goncalor/SCDTR/report/final/report.tex

\documentclass[a4paper,11pt]{article}

\usepackage{tecnico_relatorio}

\usepackage{textcomp}
\usepackage[justification=centering,hypcap]{caption} % makes \ref point to top of figures and tables
\usepackage{subcaption}
%\usepackage{rotating}
\usepackage{float}
\usepackage[nottoc]{tocbibind}
\usepackage[utf8]{inputenc}
\usepackage{graphicx}
\usepackage{listings}
\usepackage{indentfirst} % indent first paragraph in section
\usepackage{geometry}	% margins
\usepackage[siunitx]{circuitikz}	 % draw circuits
\usepackage{setspace}
\usepackage{amsmath}

% magic for listings (make them beautiful)
\usepackage{color}
\usepackage{xcolor}

%\definecolor{very-light-gray}{rgb}{0.95, 0.95, 0.95}
%\DeclareCaptionFont{white}{\color{white}}
%\DeclareCaptionFormat{listing}{\colorbox{gray}{\parbox{\textwidth}{#1#2#3}}}
%\captionsetup[lstlisting]{format=listing, labelfont=white, textfont=white}
%\lstset{backgroundcolor = \color{very-light-gray}, xleftmargin=7pt, frame=lr, framesep=7pt, framerule=0pt, breaklines=true, tabsize=4, showstringspaces=false}

% a tab is 4 spaces
%\usepackage{fancyvrb}
%\fvset{tabsize=2}

\begin{document}
\newgeometry{left=4.0cm,right=4.0cm}

\trSetImage{img/tecnico_logo}{6cm} % Logotipo do Técnico

\trSetCourse{Mestrado em Engenharia Electrotécnica \\e de Computadores}

\trSetSubject{Sistemas de Controlo Distribuído \\[3mm] em Tempo Real}

\trSetType{Project Report}

\trSetTitle{Distributed	Lighting Control}

\trSetBoxStyle{0.3}

\trSetGroupNo{Group 1}

\trSetAuthorNr{2}

\trSetAuthors
{
    \begin{center}
	Gonçalo Ribeiro

	73294
    \end{center}
}{
    \begin{center}
	João Almeida

	73198
    \end{center}
}

\trSetProfessor{Prof. José Gaspar \\ Prof. Alexandre Bernardino}

\trMakeCover

\restoregeometry
\newgeometry{left=2.5cm,right=2.5cm}

\onehalfspacing

\tableofcontents
\pagenumbering{gobble}

\pagebreak

\pagenumbering{arabic}
\setcounter{page}{1}

\input{Abstract}
\input{Introduction}
%\section{Background}
\input{Approach}
\input{Experiments}
\input{ResultsDiscussion}
\input{Conclusion}

\pagebreak
% references
\nocite{*}
\bibliography{references}
\bibliographystyle{abbrv}

\end{document}
