goncalor/SCDTR/datasheets/links.md

https://learn.adafruit.com/photocells/overview
http://www.adafruit.com/products/754		(Super Bright White LED)
