goncalor/SCDTR/report/final/img/steady_state.tex

% Title: glps_renderer figure
% Creator: GL2PS 1.3.8, (C) 1999-2012 C. Geuzaine
% For: Octave
% CreationDate: Tue Dec 29 23:09:54 2015
\setlength{\unitlength}{1pt}
\begin{picture}(0,0)

\end{picture}%
\begin{picture}(576,432)(0,0)
\fontsize{10}{0}
\selectfont\put(74.88,42.5189){\makebox(0,0)[t]{\textcolor[rgb]{0,0,0}{{0}}}}
\fontsize{10}{0}
\selectfont\put(162.409,42.5189){\makebox(0,0)[t]{\textcolor[rgb]{0,0,0}{{50}}}}
\fontsize{10}{0}
\selectfont\put(249.939,42.5189){\makebox(0,0)[t]{\textcolor[rgb]{0,0,0}{{100}}}}
\fontsize{10}{0}
\selectfont\put(337.468,42.5189){\makebox(0,0)[t]{\textcolor[rgb]{0,0,0}{{150}}}}
\fontsize{10}{0}
\selectfont\put(424.998,42.5189){\makebox(0,0)[t]{\textcolor[rgb]{0,0,0}{{200}}}}
\fontsize{10}{0}
\selectfont\put(512.527,42.5189){\makebox(0,0)[t]{\textcolor[rgb]{0,0,0}{{250}}}}
\fontsize{10}{0}
\selectfont\put(69.8755,47.52){\makebox(0,0)[r]{\textcolor[rgb]{0,0,0}{{0}}}}
\fontsize{10}{0}
\selectfont\put(69.8755,135.54){\makebox(0,0)[r]{\textcolor[rgb]{0,0,0}{{1}}}}
\fontsize{10}{0}
\selectfont\put(69.8755,223.56){\makebox(0,0)[r]{\textcolor[rgb]{0,0,0}{{2}}}}
\fontsize{10}{0}
\selectfont\put(69.8755,311.58){\makebox(0,0)[r]{\textcolor[rgb]{0,0,0}{{3}}}}
\fontsize{10}{0}
\selectfont\put(69.8755,399.6){\makebox(0,0)[r]{\textcolor[rgb]{0,0,0}{{4}}}}
\fontsize{10}{0}
\selectfont\put(298.08,31.5188){\makebox(0,0)[t]{\textcolor[rgb]{0,0,0}{{PWM value (0--255)}}}}
\fontsize{10}{0}
\selectfont\put(59.8755,223.56){\rotatebox{90}{\makebox(0,0)[b]{\textcolor[rgb]{0,0,0}{{Voltage at \texttt{A0} (\si{\volt})}}}}}
\end{picture}
