goncalor/SCDTR/report/final/img/pwm_to_lux.tex

% Title: glps_renderer figure
% Creator: GL2PS 1.3.8, (C) 1999-2012 C. Geuzaine
% For: Octave
% CreationDate: Tue Dec 29 00:58:25 2015
\setlength{\unitlength}{1pt}
\begin{picture}(0,0)

\end{picture}%
\begin{picture}(576,432)(0,0)
\fontsize{10}{0}
\selectfont\put(74.88,42.5189){\makebox(0,0)[t]{\textcolor[rgb]{0,0,0}{{0}}}}
\fontsize{10}{0}
\selectfont\put(162.409,42.5189){\makebox(0,0)[t]{\textcolor[rgb]{0,0,0}{{50}}}}
\fontsize{10}{0}
\selectfont\put(249.939,42.5189){\makebox(0,0)[t]{\textcolor[rgb]{0,0,0}{{100}}}}
\fontsize{10}{0}
\selectfont\put(337.468,42.5189){\makebox(0,0)[t]{\textcolor[rgb]{0,0,0}{{150}}}}
\fontsize{10}{0}
\selectfont\put(424.998,42.5189){\makebox(0,0)[t]{\textcolor[rgb]{0,0,0}{{200}}}}
\fontsize{10}{0}
\selectfont\put(512.527,42.5189){\makebox(0,0)[t]{\textcolor[rgb]{0,0,0}{{250}}}}
\fontsize{10}{0}
\selectfont\put(69.8755,47.52){\makebox(0,0)[r]{\textcolor[rgb]{0,0,0}{{0}}}}
\fontsize{10}{0}
\selectfont\put(69.8755,106.2){\makebox(0,0)[r]{\textcolor[rgb]{0,0,0}{{10}}}}
\fontsize{10}{0}
\selectfont\put(69.8755,164.88){\makebox(0,0)[r]{\textcolor[rgb]{0,0,0}{{20}}}}
\fontsize{10}{0}
\selectfont\put(69.8755,223.56){\makebox(0,0)[r]{\textcolor[rgb]{0,0,0}{{30}}}}
\fontsize{10}{0}
\selectfont\put(69.8755,282.24){\makebox(0,0)[r]{\textcolor[rgb]{0,0,0}{{40}}}}
\fontsize{10}{0}
\selectfont\put(69.8755,340.92){\makebox(0,0)[r]{\textcolor[rgb]{0,0,0}{{50}}}}
\fontsize{10}{0}
\selectfont\put(69.8755,399.6){\makebox(0,0)[r]{\textcolor[rgb]{0,0,0}{{60}}}}
\fontsize{10}{0}
\selectfont\put(298.08,31.5188){\makebox(0,0)[t]{\textcolor[rgb]{0,0,0}{{PWM value (0--255)}}}}
\fontsize{10}{0}
\selectfont\put(53.8755,223.56){\rotatebox{90}{\makebox(0,0)[b]{\textcolor[rgb]{0,0,0}{{Measured illuminance (\si{\lux})}}}}}
\end{picture}
