goncalor/SCDTR/report/part1/Deliverables/D2/steadystate.csv

LED, | LDR, | Volts
0, | 3, | 0.0146484375
1, | 3, | 0.0146484375
2, | 50, | 0.244140625
3, | 80, | 0.390625
4, | 104, | 0.5078125
5, | 126, | 0.615234375
6, | 145, | 0.7080078125
7, | 162, | 0.791015625
8, | 178, | 0.869140625
9, | 192, | 0.9375
10, | 207, | 1.0107421875
11, | 219, | 1.0693359375
12, | 232, | 1.1328125
13, | 243, | 1.1865234375
14, | 257, | 1.2548828125
15, | 266, | 1.298828125
16, | 275, | 1.3427734375
17, | 285, | 1.3916015625
18, | 295, | 1.4404296875
19, | 303, | 1.4794921875
20, | 312, | 1.5234375
21, | 319, | 1.5576171875
22, | 328, | 1.6015625
23, | 335, | 1.6357421875
24, | 343, | 1.6748046875
25, | 350, | 1.708984375
26, | 356, | 1.73828125
27, | 363, | 1.7724609375
28, | 369, | 1.8017578125
29, | 375, | 1.8310546875
30, | 384, | 1.875
31, | 390, | 1.904296875
32, | 393, | 1.9189453125
33, | 399, | 1.9482421875
34, | 404, | 1.97265625
35, | 409, | 1.9970703125
36, | 414, | 2.021484375
37, | 419, | 2.0458984375
38, | 424, | 2.0703125
39, | 429, | 2.0947265625
40, | 434, | 2.119140625
41, | 438, | 2.138671875
42, | 442, | 2.158203125
43, | 446, | 2.177734375
44, | 451, | 2.2021484375
45, | 454, | 2.216796875
46, | 461, | 2.2509765625
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
