goncalor/SCDTR/report/part1/Deliverables/D2/steadystate.xlsx

LED | LDR | Volts
0 | 3 | 0.0146484375
1 | 3 | 0.0146484375
2 | 50 | 0.244140625
3 | 80 | 0.390625
4 | 104 | 0.5078125
5 | 126 | 0.615234375
6 | 145 | 0.7080078125
7 | 162 | 0.791015625
8 | 178 | 0.869140625
9 | 192 | 0.9375
10 | 207 | 1.010742188
11 | 219 | 1.069335938
12 | 232 | 1.1328125
13 | 243 | 1.186523438
14 | 257 | 1.254882812
15 | 266 | 1.298828125
16 | 275 | 1.342773438
17 | 285 | 1.391601562
18 | 295 | 1.440429688
19 | 303 | 1.479492188
20 | 312 | 1.5234375
21 | 319 | 1.557617188
22 | 328 | 1.6015625
23 | 335 | 1.635742188
24 | 343 | 1.674804688
25 | 350 | 1.708984375
26 | 356 | 1.73828125
27 | 363 | 1.772460938
28 | 369 | 1.801757812
29 | 375 | 1.831054688
30 | 384 | 1.875
31 | 390 | 1.904296875
32 | 393 | 1.918945312
33 | 399 | 1.948242188
34 | 404 | 1.97265625
35 | 409 | 1.997070312
36 | 414 | 2.021484375
37 | 419 | 2.045898438
38 | 424 | 2.0703125
39 | 429 | 2.094726562
40 | 434 | 2.119140625
41 | 438 | 2.138671875
42 | 442 | 2.158203125
43 | 446 | 2.177734375
44 | 451 | 2.202148438
45 | 454 | 2.216796875
46 | 461 | 2.250976562
47 | 465 | 2.270507812
48 | 469 | 2.290039062
49 | 471 | 2.299804688
50 | 474 | 2.314453125
51 | 478 | 2.333984375
52 | 481 | 2.348632812
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
