goncalor/SCDTR/report/part1/Deliverables/D4/pwm_to_lux.csv

PWM, | ADC 0 to 1024, | Volts, | lux
0, | 2, | 0.009765625, | 0.0015958195
1, | 14, | 0.068359375, | 0.0272282088
2, | 33, | 0.1611328125, | 0.0969576472
3, | 56, | 0.2734375, | 0.2158603265
4, | 77, | 0.3759765625, | 0.3534967077
5, | 97, | 0.4736328125, | 0.509486053
6, | 116, | 0.56640625, | 0.6803579883
7, | 135, | 0.6591796875, | 0.8739853255
8, | 152, | 0.7421875, | 1.0673234428
9, | 168, | 0.8203125, | 1.2674624641
10, | 183, | 0.8935546875, | 1.4719111751
11, | 197, | 0.9619140625, | 1.6781779812
12, | 211, | 1.0302734375, | 1.9001524699
13, | 224, | 1.09375, | 2.1210871611
14, | 236, | 1.15234375, | 2.3383603645
15, | 248, | 1.2109375, | 2.56910073
16, | 259, | 1.2646484375, | 2.7930445103
17, | 269, | 1.3134765625, | 3.0074560374
18, | 280, | 1.3671875, | 3.2558000438
19, | 290, | 1.416015625, | 3.4934731446
20, | 299, | 1.4599609375, | 3.7175369932
21, | 307, | 1.4990234375, | 3.925137115
22, | 316, | 1.54296875, | 4.1685801272
23, | 324, | 1.58203125, | 4.3941355856
24, | 332, | 1.62109375, | 4.6286800779
25, | 340, | 1.66015625, | 4.8725855995
26, | 347, | 1.6943359375, | 5.093990332
27, | 355, | 1.7333984375, | 5.3565246962
28, | 361, | 1.7626953125, | 5.5603257703
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
