goncalor/SCDTR/report/part1/Deliverables/D4/pwm_to_lux.xlsx

PWM | ADC 0 to 1024 | Volts | lux | a | -0.6901
0 | 2 | 0.009765625 | 0.00159581951 | b | 4.7782
1 | 14 | 0.068359375 | 0.02722820881 | R | 10000
2 | 33 | 0.1611328125 | 0.09695764723
3 | 56 | 0.2734375 | 0.2158603265
4 | 77 | 0.3759765625 | 0.3534967077
5 | 97 | 0.4736328125 | 0.509486053
6 | 116 | 0.56640625 | 0.6803579883
7 | 135 | 0.6591796875 | 0.8739853255
8 | 152 | 0.7421875 | 1.067323443
9 | 168 | 0.8203125 | 1.267462464
10 | 183 | 0.8935546875 | 1.471911175
11 | 197 | 0.9619140625 | 1.678177981
12 | 211 | 1.030273438 | 1.90015247
13 | 224 | 1.09375 | 2.121087161
14 | 236 | 1.15234375 | 2.338360365
15 | 248 | 1.2109375 | 2.56910073
16 | 259 | 1.264648438 | 2.79304451
17 | 269 | 1.313476562 | 3.007456037
18 | 280 | 1.3671875 | 3.255800044
19 | 290 | 1.416015625 | 3.493473145
20 | 299 | 1.459960938 | 3.717536993
21 | 307 | 1.499023438 | 3.925137115
22 | 316 | 1.54296875 | 4.168580127
23 | 324 | 1.58203125 | 4.394135586
24 | 332 | 1.62109375 | 4.628680078
25 | 340 | 1.66015625 | 4.872585599
26 | 347 | 1.694335938 | 5.093990332
27 | 355 | 1.733398438 | 5.356524696
28 | 361 | 1.762695312 | 5.56032577
29 | 368 | 1.796875 | 5.805853545
30 | 374 | 1.826171875 | 6.023188681
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
