goncalor/SCDTR/report/part1/Deliverables/D1/12188851_10206899565321801_85842977_n.jpg

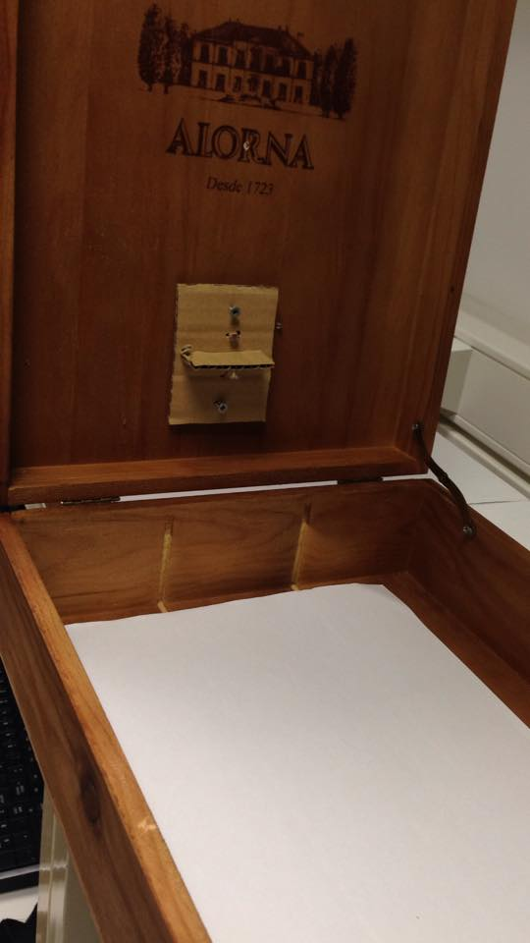
report/part1/Deliverables/D1/12188851_10206899565321801_85842977_n.jpg
