goncalor/SCDTR/Arduino/step_response/step_response_no_capacitor.csv

time, | LDR, | LED
1000456, | 6, | 0
1001072, | 5, | 0
1001728, | 6, | 0
1002376, | 5, | 0
1003024, | 6, | 0
1003680, | 5, | 0
1004328, | 5, | 0
1004976, | 4, | 0
1005632, | 5, | 0
1006824, | 6, | 0
1008096, | 6, | 0
1009368, | 6, | 0
1010648, | 5, | 0
1011920, | 5, | 0
1013192, | 5, | 0
1014472, | 5, | 0
1015744, | 5, | 0
1017016, | 6, | 0
1018296, | 5, | 0
1019568, | 6, | 0
1020856, | 5, | 128
1022288, | 88, | 128
1023816, | 140, | 128
1025432, | 214, | 128
1027048, | 236, | 128
1028664, | 316, | 128
1030280, | 315, | 128
1031896, | 369, | 128
1033512, | 391, | 128
1035128, | 405, | 128
1036736, | 445, | 128
1038352, | 432, | 128
1039968, | 461, | 128
1041584, | 468, | 128
1043200, | 491, | 128
1044816, | 504, | 128
1046432, | 500, | 128
1048048, | 530, | 128
1049664, | 506, | 128
1051272, | 543, | 128
1052888, | 533, | 128
1054504, | 542, | 128
1056120, | 554, | 128
1057736, | 542, | 128
1059352, | 570, | 128
1060968, | 545, | 128
1062576, | 572, | 128
1064192, | 566, | 128
1065808, | 567, | 128
1067424, | 581, | 128
1069040, | 564, | 128
1070656, | 593, | 128
1072272, | 570, | 128
1073888, | 587, | 128
1075504, | 587, | 128
1077112, | 581, | 128
1078728, | 598, | 128
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
