goncalor/SCDTR/Arduino/step_response/step_response.csv

time, | LDR, | LED
1000472, | 4, | 0
1001088, | 4, | 0
1001744, | 4, | 0
1002392, | 4, | 0
1003040, | 4, | 0
1003696, | 4, | 0
1004344, | 4, | 0
1004992, | 3, | 0
1005648, | 4, | 0
1006832, | 4, | 0
1008112, | 4, | 0
1009384, | 4, | 0
1010664, | 4, | 0
1011936, | 3, | 0
1013208, | 4, | 0
1014488, | 3, | 0
1015760, | 3, | 0
1017040, | 4, | 0
1018312, | 3, | 0
1019584, | 4, | 0
1020872, | 4, | 128
1022304, | 11, | 128
1023832, | 24, | 128
1025368, | 47, | 128
1026896, | 73, | 128
1028424, | 105, | 128
1030040, | 140, | 128
1031656, | 179, | 128
1033272, | 213, | 128
1034888, | 250, | 128
1036504, | 285, | 128
1038120, | 316, | 128
1039728, | 345, | 128
1041344, | 369, | 128
1042960, | 395, | 128
1044576, | 416, | 128
1046192, | 432, | 128
1047808, | 452, | 128
1049424, | 464, | 128
1051032, | 480, | 128
1052648, | 489, | 128
1054264, | 502, | 128
1055880, | 509, | 128
1057496, | 516, | 128
1059112, | 525, | 128
1060728, | 529, | 128
1062344, | 538, | 128
1063952, | 541, | 128
1065568, | 547, | 128
1067184, | 552, | 128
1068800, | 554, | 128
1070416, | 560, | 128
1072032, | 561, | 128
1073648, | 566, | 128
1075264, | 568, | 128
1076872, | 571, | 128
1078488, | 576, | 128
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
