goncalor/SCDTR/graphs/AvgStepRespTau.png

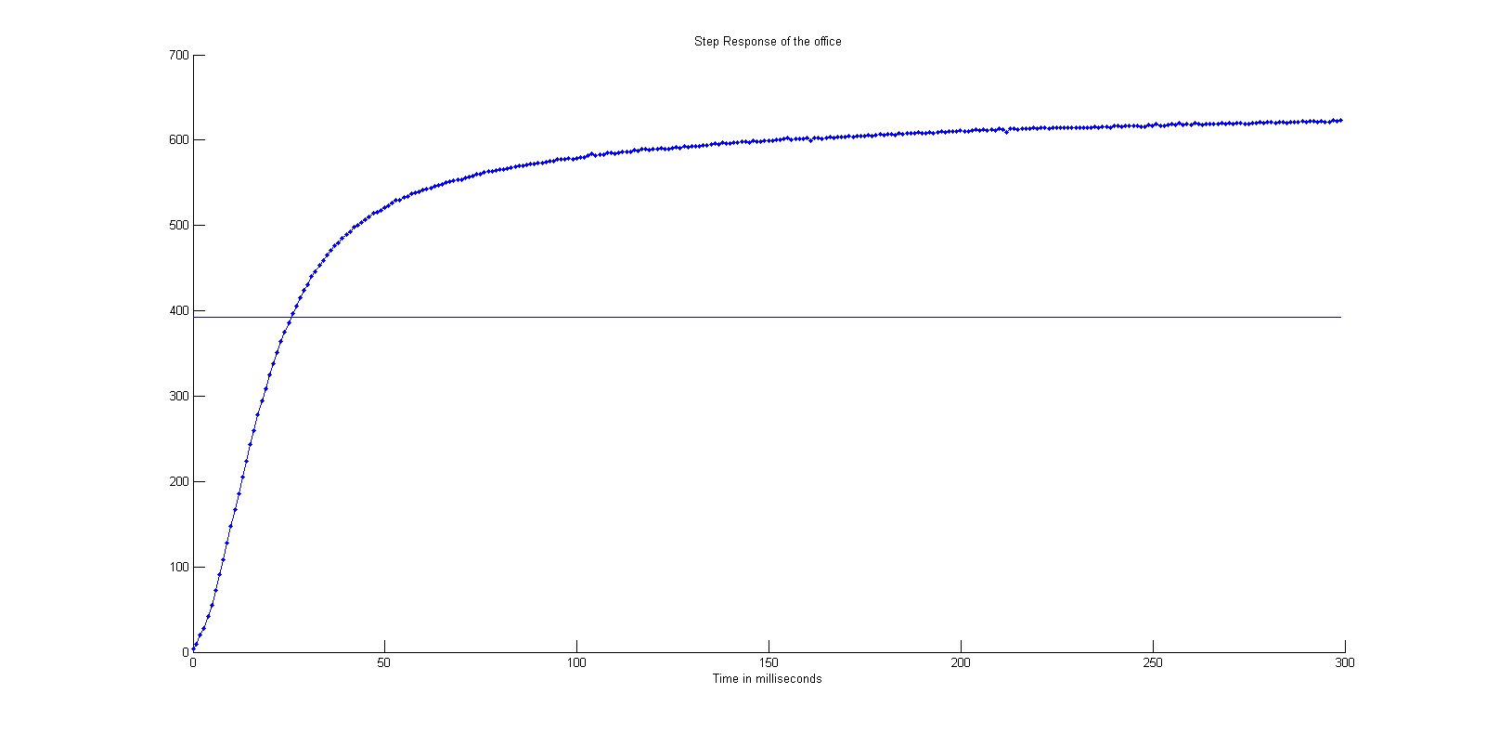
graphs/AvgStepRespTau.png
