goncalor/SCDTR/report/final/SystemCharacteristics.tex

\subsection{System Characteristics}
\label{sec:SystemCharacteristics}

\subsubsection{Steady State}
\label{sub:SteadyState}

The steady state response of the system was determined by setting the duty cycle of the LED to all values in the PWM range 0--255. Each sample was acquired \SI{200}{\milli\second} after the previous one so that the system had time to reach a steady state. This is an adequate time between samples because $RC$ constant of the detector circuit in \autoref{fig:setup_LDR_circuit} is $\tau = R_2C_1 = \SI{60}{\milli\second}$ and \SI{400}{\milli\second} amounts to more than $3\tau$. The reason why $R_2$ is in the time constant and not $R_3$ is because the PWM value was incremented and hence $C_1$ charges via $R_2$. If the data was acquired while decrementing the PWM value $R_3$ would be used instead.

% explain R_2's value above?

A graph of the acquired data can be seen in \autoref{fig:steady_state}. We conclude that the resistance of the LDR does not vary linearly with the duty cycle on the LED. Nonetheless it is possible to obtain a linear function relating the input an output of the system, as described in \ref{subsubsec:LDR_model}.

\begin{figure}[h]
    \centering
    \resizebox{\textwidth}{!}{\input{img/steady_state}}
    \caption{Steady state voltage at pin \texttt{A0} as a function of the duty cycle of the LED.}
    \label{fig:steady_state}
\end{figure}

\subsubsection{Modeling the LDR}
\label{subsubsec:LDR_model}

Since the steady state plot in \autoref{fig:steady_state} reveals that the system is nonlinear it is useful to understand why. The main sources from nonlinearity should result from the LED, the LDR or a combination of both.

% TODO put full datasheet in an annex?

With that in mind the LDR datasheet was analysed. On it the graph in \autoref{fig:LDR_datasheet} can be found. This graph gives a range of values for the resistance of the LDR for each value of incident illuminance. To produce an equation that models the LDR resistance as a function of illuminance the resistance value used for the model is the mean of the maximum and minimum values given for each illuminance. The final result should be a function which produces a line that crosses the middle of the dark region in \autoref{fig:LDR_datasheet}. Note the axis of the figure are both in logarithmic scale. The considered points to obtain this linear function (in a log-log reference) were $(L_1, R_1) = (\SI{100}{\lux}; \SI{2.5}{\kilo\ohm})$ and $(L_2, R_2) = (\SI{1}{\lux}; \SI{60}{\kilo\ohm})$. The model will be an equation in the form
\begin{equation} \label{eq:log-log_line}
    \log_{10} R_{LDR} = a \log_{10} L + b.
\end{equation}

\begin{figure}[h]
    \centering
    \begin{subfigure}[t]{0.39\textwidth}
	\centering
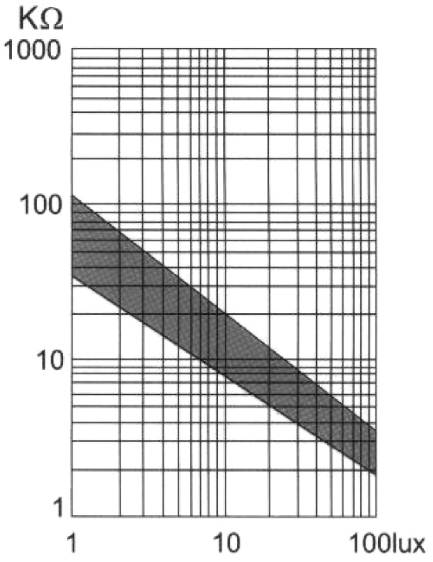
[picture p15: report/final/img/LDR_datasheet.png]
	
	\caption{LDR resistance as a function of illuminance according to the GL5528's datasheet.}
	\label{fig:LDR_datasheet}
    \end{subfigure}
    \begin{subfigure}[t]{0.59\textwidth}
	\centering
	
	\caption{Model for the resistance of the LDR as function of the incident illuminance.}
	\label{fig:LDR_model}
    \end{subfigure}
    \caption{LDR characteristic.}
    %\label{fig:LDR_characteristic}
\end{figure}

We can substitute $(L_1, R_1)$ and $(L_2, R_2)$ in \eqref{eq:log-log_line} to obtain the system of equations
\begin{equation} \label{eq:log-log_line_system}
    \begin{bmatrix}
	\log_{10}R_1 \\ \log_{10}R_2
    \end{bmatrix}
    =
    \begin{bmatrix}
	\log_{10}L_1  &  1 \\
	\log_{10}L_2  &  1
    \end{bmatrix}
    \begin{bmatrix}
	a \\ b
    \end{bmatrix}.
\end{equation}
By solving the system the values $a \approx -0.6901$ and $b \approx 4.7782$ are obtained for this case.

With the values for $a$ and $b$ and \eqref{eq:log-log_line} it is possible to plot the graph in \autoref{fig:LDR_model} which models the LDR characteristic, as desired. Using \eqref{eq:log-log_line} it is possible to obtain the incident illuminance ($L$) from the resistance of the LDR $R_{LDR}$
\begin{equation} \label{eq:Rldr_to_lux}
    L = 10^{-\frac{b}{a}} R_{LDR}^{\frac{1}{a}} .
\end{equation}
And since in a steady state
\begin{equation} \label{eq:VA0_to_Rldr}
    R_{LDR} = \frac{V_S R_3}{V_{\texttt{A0}}} - R_3 ,
\end{equation}
we can substitute \eqref{eq:VA0_to_Rldr} in \eqref{eq:Rldr_to_lux} and apply the new equation to the plot in \autoref{fig:steady_state} to produce the plot in \autoref{fig:pwm_to_lux} which relates the duty cycle of the LED to the illuminance measured by the LDR. We can conclude that the illuminance varies linearly with the duty cycle applied to the LED.

\begin{figure}[h]
    \centering
    \resizebox{0.75\textwidth}{!}{\input{img/pwm_to_lux}}
    \caption{Illuminance detected by the LDR in function of the duty cycle of the LED.}
    \label{fig:pwm_to_lux}
\end{figure}

\subsubsection{Step Response}
\label{sub:StepResponse}

To plot the step response of the system an Arduino program was written that to produce a step and acquire data to be plotted. In this script the LED is first turned off for \SI{1}{\second} so that the capacitor ``fully'' discharges. Then a step is applied to the system by setting the LED duty cycle to 0.5. A sample is acquired and sent to the computer approximately every \SI{1.35}{\milli\second}. The readings are converted to Volt and the result is \autoref{fig:step_response}.

An inflection point can be perceived early in the step response. From this follows that the system's order must be at least second degree. The detector in \autoref{fig:setup_LDR_circuit} includes a capacitor, which must introduce a pole. Therefore an experiment was made which consisted simply in removing the capacitor and acquiring the step response again. The result is shown in \autoref{fig:step_response_no_capacitor} where it can be seen that the aforementioned inflection does not exist. It is also noticeable that introducing the capacitor does filter high frequency noise, as expected. Therefore introducing the capacitor improves the readings but makes the system order increase. Nonetheless the capacitor value can be changed allowing to control the pole position and cutoff frequency.

Assuming that the system can be approximated to a first order system of the form $G(s) = K_0/(1+s\tau)$ the system can be modelled by finding the static gain $K_0$ and the time constant $\tau$. $K_0$ is calculated as the ratio of the output and the input under steady state; the time constant is the time the system takes to reach $1-e^{-1} \approx 63 \%$ of its final value. Therefore for \autoref{fig:step_response} the static gain is $3.08/2.5 = 1.232$ and the time constant is approximately $\SI{23}{\milli\second}$.

If the system is linearised by using the transformation presented in \ref{subsubsec:LDR_model} \autoref{fig:step_response_linearised} is obtained. In this case the static gain is $26.4/2.5 = 10.6$ and the time constant is approximately $\SI{47}{\milli\second}$.

\begin{figure}[h]
    \centering
    \begin{subfigure}[t]{0.49\textwidth}
	\centering
	
	\caption{With capacitor, not linearised.}
	\label{fig:step_response}
    \end{subfigure}
    \begin{subfigure}[t]{0.49\textwidth}
	\centering
	
	\caption{With capacitor, linearised.}
	\label{fig:step_response_linearised}
    \end{subfigure}

    \begin{subfigure}[t]{0.49\textwidth}
	\centering
	
	\caption{No capacitor, not linearised.}
	\label{fig:step_response_no_capacitor}
    \end{subfigure}
    \caption{Response of the system to a step with 50\% duty cycle applied at time \SI{20}{\milli\second}.}
    %\label{fig:}
\end{figure}

\subsubsection{Incremental Response}
\label{sub:IncrementalResponse}

An incremental step response was also produced (\autoref{fig:incstep}). For this, incremental steps of 10 PWM units (3.92\% duty cycle) were used every \SI{400}{\milli\second}. A sample was acquired approximately every \SI{1.35}{\milli\second}.

The acquired data is noisy and therefore it is difficult to measure the time constants for most of the steps.

\begin{figure}[h]
    \begin{subfigure}[t]{0.49\textwidth}
	\centering
	
	\caption{Not linearised.}
	\label{fig:incstep_response}
    \end{subfigure}
    \begin{subfigure}[t]{0.49\textwidth}
	\centering
	
	\caption{Linearised.}
	\label{fig:incstep_response_linearised}
    \end{subfigure}
    \caption{Incremental step responses with increments of 3.92\% duty cycle. First step is at \SI{20}{\milli\second}.}
    \label{fig:incstep}
\end{figure}
