goncalor/SCDTR/graphs/test excels.xlsx

Sheet: Sheet1
time | full_ctrl_u | ctrl_y | ctrl_e | p | i | d | ctrl_e_sat | lux | ctrl_mapped_ref
4 | 272 | 0 | 509 | 1018 | 25 | 0 | -68 | 0 | 509
5268 | 257 | 37 | 472 | 944 | 40 | 0 | -8 | 0 | 509
10516 | 195 | 179 | 330 | 660 | 76 | 0 | 0 | 1 | 509
15624 | 135 | 313 | 196 | 392 | 102 | 0 | 0 | 4 | 509
20732 | 98 | 394 | 115 | 230 | 117 | 0 | 0 | 6 | 509
25840 | 84 | 428 | 81 | 162 | 126 | 0 | 0 | 8 | 509
30948 | 81 | 437 | 72 | 144 | 133 | 0 | 0 | 8 | 509
36056 | 82 | 439 | 70 | 140 | 140 | 0 | 0 | 8 | 509
41164 | 82 | 442 | 67 | 134 | 146 | 0 | 0 | 9 | 509
46276 | 81 | 446 | 63 | 126 | 152 | 0 | 0 | 9 | 509
51384 | 81 | 450 | 59 | 118 | 158 | 0 | 0 | 9 | 509
56492 | 80 | 453 | 56 | 112 | 163 | 0 | 0 | 9 | 509
61600 | 80 | 457 | 52 | 104 | 168 | 0 | 0 | 9 | 509
66708 | 79 | 461 | 48 | 96 | 173 | 0 | 0 | 10 | 509
71808 | 79 | 463 | 46 | 92 | 177 | 0 | 0 | 10 | 509
76912 | 79 | 465 | 44 | 88 | 181 | 0 | 0 | 10 | 509
82012 | 78 | 468 | 41 | 82 | 185 | 0 | 0 | 10 | 509
87112 | 78 | 471 | 38 | 76 | 188 | 0 | 0 | 10 | 509
92216 | 77 | 473 | 36 | 72 | 191 | 0 | 0 | 10 | 509
97316 | 78 | 473 | 36 | 72 | 194 | 0 | 0 | 10 | 509
102420 | 77 | 476 | 33 | 66 | 197 | 0 | 0 | 10 | 509
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
