goncalor/SCDTR/graphs/PI tests.xlsx

Sheet: PI with antiwindup
Time in s | [write_t, | ctrl_u | ctrl_y, | ctrl_e, | ctrl_ref,
0.000728 | 728 | 255 | 2 | 509 | 511
0.005904 | 5904 | 210 | 93 | 418 | 511
0.011208 | 11208 | 123 | 269 | 242 | 511
0.01636 | 16360 | 59 | 398 | 113 | 511
0.021504 | 21504 | 42 | 433 | 78 | 511
0.026648 | 26648 | 42 | 433 | 78 | 511
0.0318 | 31800 | 48 | 421 | 90 | 511
0.036944 | 36944 | 52 | 414 | 97 | 511
0.042088 | 42088 | 54 | 411 | 100 | 511
0.04724 | 47240 | 52 | 415 | 96 | 511
0.052396 | 52396 | 52 | 416 | 95 | 511
0.05754 | 57540 | 50 | 420 | 91 | 511
0.062684 | 62684 | 50 | 420 | 91 | 511
0.067828 | 67828 | 49 | 423 | 88 | 511
0.072972 | 72972 | 49 | 422 | 89 | 511
0.078124 | 78124 | 49 | 424 | 87 | 511
0.083268 | 83268 | 49 | 424 | 87 | 511
0.088412 | 88412 | 49 | 425 | 86 | 511
0.093564 | 93564 | 48 | 427 | 84 | 511
0.098708 | 98708 | 48 | 427 | 84 | 511
0.103852 | 103852 | 48 | 428 | 83 | 511
0.109 | 109000 | 48 | 428 | 83 | 511
0.114152 | 114152 | 47 | 430 | 81 | 511
0.119304 | 119304 | 48 | 429 | 82 | 511
0.124464 | 124464 | 48 | 430 | 81 | 511
0.129616 | 129616 | 48 | 430 | 81 | 511
0.134768 | 134768 | 47 | 431 | 80 | 511
0.139928 | 139928 | 48 | 431 | 80 | 511
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
