goncalor/SCDTR/report/final/img/GlobalSystem.pdf

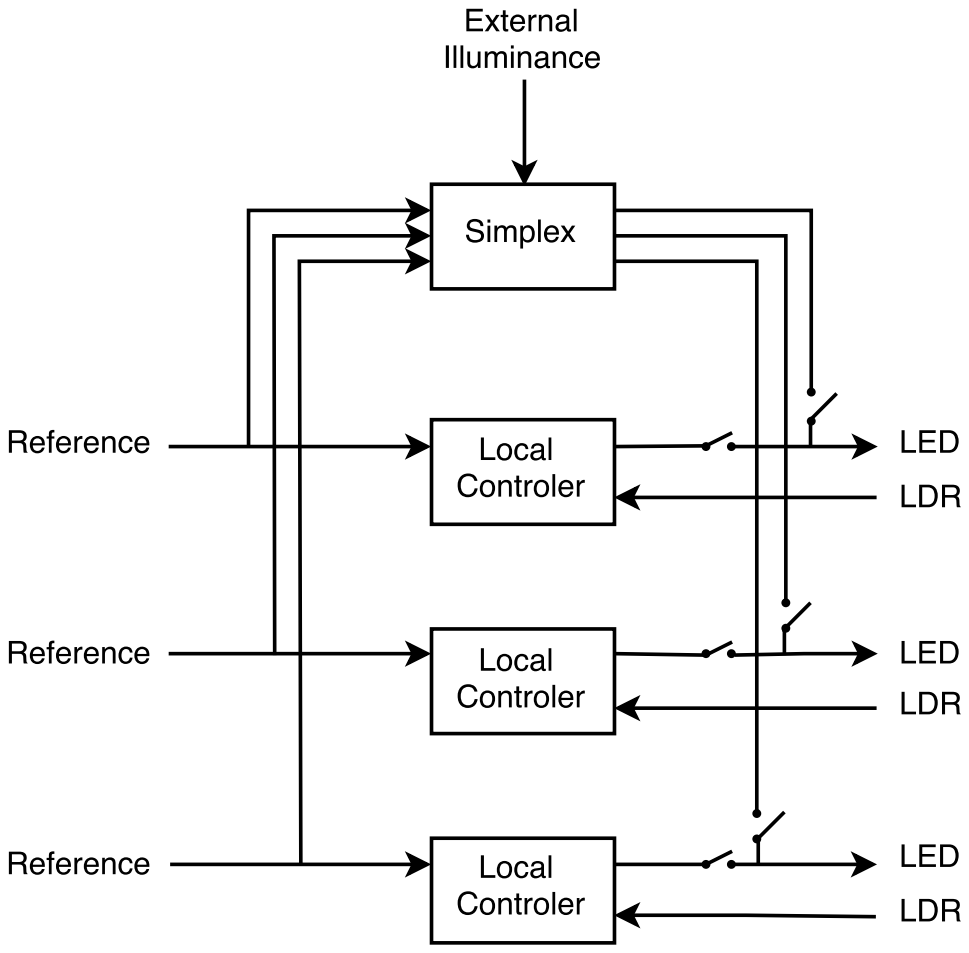
[picture p22: page 1]
