goncalor/SCDTR/report/final/img/pid_block_diagram.pdf

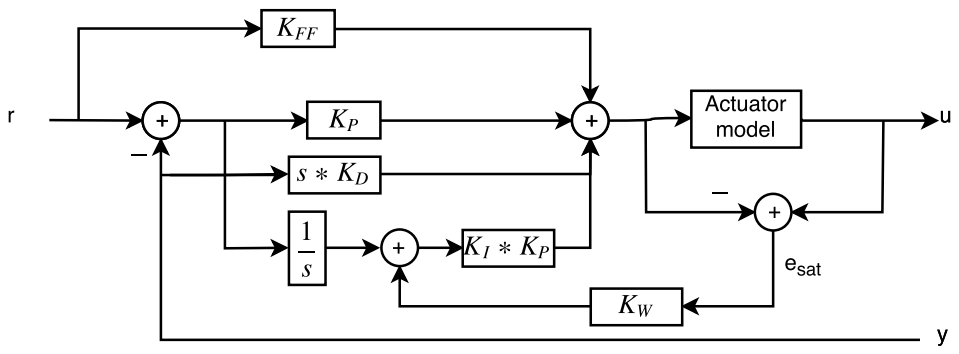
[picture p23: page 1]
