goncalor/SCDTR/labs/lab10/slavex/slavex.ino

// Written by Nick Gammon
// February 2011
// http://gammon.com.au/i2c

#include <Wire.h>

byte MY_ADDRESS = 0;// me
int inPin1 = 2;
int inPin2 = 3;
const byte LED = 13;// LED is on pin 13
byte ledVal = 0;

void receiveEvent (int howMany){
  // we are expecting 2 bytes, so check we got them
  if (howMany == 2){
    int result;
    result = Wire.read ();
    result <<= 8;
    result |= Wire.read ();

    // do something with result here ...
    // for example, flash the LED
    digitalWrite (LED, ledVal ^= 1);   // flash the LED

  }  // end if 2 bytes were sent to us

  // throw away any garbage
  while (Wire.available () > 0)
  Wire.read ();

}  // end of receiveEvent


void setup (){
  pinMode(inPin1, INPUT_PULLUP);
  pinMode(inPin2, INPUT_PULLUP);
  MY_ADDRESS = digitalRead(inPin1) + (digitalRead(inPin2)<<1) + 4;

  Serial.begin(9600);
  Serial.print("Slave addr = "); Serial.println(MY_ADDRESS);

  Wire.begin( MY_ADDRESS );  // initialize hardware registers etc.
  TWAR = (MY_ADDRESS << 1) | 1;  // enable broadcasts to be received
  Wire.onReceive( receiveEvent );  // set up receive handler

  pinMode(LED, OUTPUT);          // for debugging, allow LED to be flashed
}  // end of setup


void loop ()  {}  // end of loop, doing nothing
