goncalor/SCDTR/labs/lab10/find_i2c_slaves/find_i2c_slaves.ino

// I2C Scanner
// Written by Nick Gammon
// Date: 20th April 2011
// http://gammon.com.au/i2c
// http://forum.arduino.cc/index.php?topic=61520.0

#include <Wire.h>

const byte MY_ADDRESS = 40; // me

void setup(){
  //Serial.begin (115200);
  Serial.begin (9600);
  Serial.println ();
  Serial.println ("I2C scanner. Scanning ...");
  byte count = 0;

  // Wire.begin(); // use this line to be just master
  Wire.begin(MY_ADDRESS); // use this line to be master or slave40

  for (byte i = 1; i < 120; i++){
    Wire.beginTransmission (i);
    if (Wire.endTransmission () == 0){
      Serial.print ("Found address: ");
      Serial.print (i, DEC);
      Serial.print (" (0x");
      Serial.print (i, HEX);
      Serial.println (")");
      count++;
    } // end of good response
    delay (5);  // give devices time to recover
  } // end of for loop
  Serial.println ("Done.");
  Serial.print ("Found ");
  Serial.print (count, DEC);
  Serial.println (" device(s).");
}  // end of setup

void loop() {} // do nothing
