goncalor/SCDTR/server/cpp_simplex/main.cpp

// g++ -Wall -Wextra -pedantic -std=c++11 -g simplex.cpp main.cpp

#include "simplex.hpp"
#include "../utils.hpp"
#include <iostream>
#include <vector>


/* INPUT
N = [1,2,3];
B = [4,5,6];
A = [1, 1, 3;
     2, 2, 5;
     4, 1, 2];
b = [30;24;36];
c = [3,1,2];
v = 0;
l = 6;
e = 1;
*/

/* OUTPUT
N = [6;2;3];
B = [4;5;1];
A = [-0.2500    0.7500    2.5000;
     -0.5000    1.5000    4.0000;
      0.2500    0.2500    0.5000];
b = [21;6;9];
c = [-0.7500, 0.25, 0.5];
v = 27;


N = [2;3;6];
B = [1;4;5];
A = [
     1.5     4     -0.5;
     0.25    0.5    0.25;
     0.75    2.5   -0.25;
    ];
b = [9;21;6];
c = [ 0.25, 0.5, -0.7500];
v = 27;


*/

int main() {
/*
    Simplex::pivot_struct test_struct;
    Simplex::pivot_struct out_struct;

    test_struct.v=0;
    test_struct.N.insert(1);
    test_struct.N.insert(2);
    test_struct.N.insert(3);
    test_struct.B.insert(4);
    test_struct.B.insert(5);
    test_struct.B.insert(6);

    test_struct.c[1]=3;
    test_struct.c[2]=1;
    test_struct.c[3]=2;

    test_struct.b[4]=30;
    test_struct.b[5]=24;
    test_struct.b[6]=36;

    std::map<int,float> A_l1;
    std::map<int,float> A_l2;
    std::map<int,float> A_l3;

    test_struct.A[4]=A_l1;
    test_struct.A[5]=A_l2;
    test_struct.A[6]=A_l3;

    test_struct.A[4][1]=1;
    test_struct.A[5][1]=2;
    test_struct.A[6][1]=4;
    test_struct.A[4][2]=1;
    test_struct.A[5][2]=2;
    test_struct.A[6][2]=1;
    test_struct.A[4][3]=3;
    test_struct.A[5][3]=5;
    test_struct.A[6][3]=2;

    int e = 1;
    int l = 6;

    //std::cout << "Before Pivot" <<std::endl;

    //Simplex::print_pivot_struct(test_struct);

    out_struct = Simplex::pivot(test_struct,e,l);

    //std::cout << "After Pivot" <<std::endl;

    //Simplex::print_pivot_struct(out_struct);
*/

/*
    std::vector<float> b;
    b.push_back(30);
    b.push_back(24);
    b.push_back(36);
    std::vector<float> c;
    c.push_back(3);
    c.push_back(1);
    c.push_back(2);
    std::vector<std::vector<float>> A;
    A.push_back(std::vector<float> ());
    A.push_back(std::vector<float> ());
    A.push_back(std::vector<float> ());
    A[0].push_back(1);
    A[0].push_back(1);
    A[0].push_back(3);
    A[1].push_back(2);
    A[1].push_back(2);
    A[1].push_back(5);
    A[2].push_back(4);
    A[2].push_back(1);
    A[2].push_back(2);

    std::cout << "Create Simplex" <<std::endl;

    Simplex teste = Simplex(A,b,c);

    std::cout << "Print" <<std::endl;

    teste.print_internal_struct();

    std::vector<float> x = teste.solve();


    std::cout << "Solution" <<std::endl;

    for(auto i : x){
        std::cout << "x = " << i << std::endl;
    }



    std::cout << "Without initial feasible solution: " <<std::endl;

    std::vector<float> b1;
    b1.push_back(2);
    b1.push_back(-4);

    std::vector<float> c1;
    c1.push_back(2);
    c1.push_back(-1);

    std::vector<std::vector<float>> A1;
    A1.push_back(std::vector<float> ());
    A1.push_back(std::vector<float> ());
    A1[0].push_back(2);
    A1[0].push_back(-1);
    A1[1].push_back(1);
    A1[1].push_back(-5);

    Simplex teste1 = Simplex(A1,b1,c1);

    std::cout << "Print" <<std::endl;

    teste1.print_internal_struct();

    std::vector<float> x1 = teste1.solve();

    std::cout << "Solution" <<std::endl;

    std::cout << "Size: " << x1.size() << std::endl;

    for(auto i : x1){
        std::cout << "x = " << i << std::endl;
    }
    std::cout << std::endl<< std::endl;
*/
// TEST with Arduino LP

/*
# Created by Octave 3.8.1, Thu Dec 10 09:46:19 2015 WET <jmirandadealme@JMdeA-Zenbook>
# name: A
# type: matrix
# rows: 18
# columns: 9
 -10.21830350832508 -0.7271861952428118 -0.09748519653650334 -0.7271861952428118 -0.2769996701683155 -0.06890464691960219 -0.09748519653650334 -0.06890464691960219 -0.03280392761204531
 -0.7271861952428118 -10.21830350832508 -0.7271861952428118 -0.2769996701683155 -0.7271861952428118 -0.2769996701683155 -0.06890464691960219 -0.09748519653650334 -0.06890464691960219
 -0.09748519653650334 -0.7271861952428118 -10.21830350832508 -0.06890464691960219 -0.2769996701683155 -0.7271861952428118 -0.03280392761204531 -0.06890464691960219 -0.09748519653650334
 -0.7271861952428118 -0.2769996701683155 -0.06890464691960219 -10.21830350832508 -0.7271861952428118 -0.09748519653650334 -0.7271861952428118 -0.2769996701683155 -0.06890464691960219
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

    teste4.print_internal_struct();

    std::vector<float> x4 = teste4.solve();

    std::cout << "Solution" <<std::endl;

    for(auto i : x4){
        std::cout << "x = " << i << std::endl;
    }

*/


/*
N = {2,5,}
B = {1,3,4,}
A = {
0,-1,
1,2,
3,4,
}
b = {20,60,160,}
c = {5,7,}
v = 140
*/

/*
std::vector<std::vector<float>> A5;
A5.push_back(std::vector<float> ());
A5.push_back(std::vector<float> ());
A5.push_back(std::vector<float> ());
A5[0].push_back(0);
A5[0].push_back(-1);
A5[1].push_back(1);
A5[1].push_back(2);
A5[2].push_back(3);
A5[2].push_back(4);


std::vector<float> b5;
b5.push_back(20);
b5.push_back(60);
b5.push_back(160);

std::vector<float> c5;
c5.push_back(5);
c5.push_back(7);


Simplex teste5 = Simplex(A5,b5,c5);
std::vector<float> x5 = teste5.solve();

std::cout << "Solution" <<std::endl;

for(auto i : x5){
    std::cout << "x = " << i << std::endl;
}
*/


/*isto é para aberto

O_vals: 198 236 260
E_vals:
708 275 269
579 640 284
380 560 581
*/
  /*
std::vector<std::vector<float>> E;
std::vector<float> O;
std::vector<float> L;
E.push_back(std::vector<float>());
E.push_back(std::vector<float>());
E.push_back(std::vector<float>());
O.push_back(198.0/1024);
O.push_back(236.0/1024);
O.push_back(260.0/1024);
L.push_back(600.0/1024);
L.push_back(600.0/1024);
L.push_back(600.0/1024);
E[0].push_back(708.0/1024);
E[0].push_back(275.0/1024);
E[0].push_back(269.0/1024);
E[1].push_back(579.0/1024);
E[1].push_back(640.0/1024);
E[1].push_back(284.0/1024);
E[2].push_back(380.0/1024);
E[2].push_back(560.0/1024);
E[2].push_back(581.0/1024);

lp_struct lp = generate_linear_programm(E,O,L);

Simplex teste = Simplex(lp.A,lp.b,lp.c);

std::vector<float> x = teste.solve();

for(auto i : x){
    std::cout << "x = " << i*255 << std::endl;
}
*/

/*fechado

O_vals: 5 3 3
E_vals:
745 137 67
598 704 113
317 586 674*/

std::vector<std::vector<float>> E;
std::vector<float> O;
std::vector<float> L;
E.push_back(std::vector<float>());
E.push_back(std::vector<float>());
E.push_back(std::vector<float>());
O.push_back(5.0/1024);
O.push_back(3.0/1024);
O.push_back(3.0/1024);
L.push_back(600.0/1024);
L.push_back(600.0/1024);
L.push_back(600.0/1024);
E[0].push_back(745.0/1024);
E[0].push_back(137.0/1024);
E[0].push_back(67.0/1024);
E[1].push_back(598.0/1024);
E[1].push_back(704.0/1024);
E[1].push_back(113.0/1024);
E[2].push_back(317.0/1024);
E[2].push_back(586.0/1024);
E[2].push_back(674.0/1024);

lp_struct lp = generate_linear_programm(E,O,L);

Simplex teste = Simplex(lp.A,lp.b,lp.c);

std::vector<float> x = teste.solve();

for(auto i : x){
  std::cout << "x = " << i*255 << std::endl;
}

}
