goncalor/SCDTR/Arduino/main_/utils.cpp

#include <stdlib.h>
#include <ctype.h>
#include <string.h>


/* Turns spaces in 'str' into \0s and and writes a list of pointers to the
 * beginning of words into 'splitlst'.  Only the first 'splitlstlen' words are
 * written into 'splitlst'. 'splitlstlen' must be at most the length of
 * 'splitlst'.  The unused positions in 'splitlst' will be NULL.  Returns the
 * number of words read. Returns at most 'splitlstlen'. */
short split(char *str, char **splitlst, short splitlstlen)
{
    short lstindex;
    char *c;
    bool prevnotspace = false;   // whether the prev char was a space

    // intialise 'splitlst' with NULLs
    for(lstindex=0; lstindex < splitlstlen; lstindex++)
        splitlst[lstindex] = NULL;

    c = str;
    lstindex = 0;
    // while \0 is not found and read less than 'splitlstlen'
    while(*c && lstindex < splitlstlen)
    {
        if(isspace(*c))
        {
            // terminate previous string
            *c = '\0';
            if(prevnotspace)
                lstindex++;
            prevnotspace = false;
        }
        else
        {
            if(!prevnotspace)
                splitlst[lstindex] = c;
            prevnotspace = true;
        }

        c++;
    }

    // case of string ...xyz\0
    if(prevnotspace)
        lstindex++;

    return lstindex;
}


/* Convert a float to a string. Converts the float value from 'val' into an
 * ASCII representation that will be stored under s. The caller is responsible
 * for providing sufficient storage in s. Returns 's'.  Note: the string will
 * have only 2 decimal places */
// TODO: improve this for big floats and negative floats
char *ftoa(float val, char *s)
{
    int integer = (int) val;
    float fractional = val - integer;
    short aux;

    itoa(integer, s, 10);
    aux = strlen(s);
    s[aux] = '.';
//    itoa((int)fractional*100, s+aux+1, 10);

    integer = fractional*100;
    s[aux+2] = integer % 10 + '0';
    integer /= 10;
    s[aux+1] = integer + '0';
    s[aux+3] = 0;

    return s;
}
