goncalor/SCDTR/server/cpp_simplex/simplex.hpp

#ifndef SIMPLEX_HPP
#define SIMPLEX_HPP

#include <vector>
#include <set>
#include <map>



class Simplex {


public:

    struct pivot_struct{
        std::map<int,std::map<int,float>> A;
        std::map<int,float> b;
        std::map<int,float> c;
        std::set<int> N;
        std::set<int> B;
        float v;
    };

    Simplex(std::vector<std::vector<float>>,std::vector<float>,std::vector<float>);

    std::vector<float> solve();

    static pivot_struct pivot(pivot_struct in, int e, int l);

    static void print_pivot_struct(pivot_struct to_print);

    void init_Simplex();

    void print_internal_struct(){
        print_pivot_struct(internal_struct);
    }

private:
    pivot_struct internal_struct;
    bool simplex_ended(pivot_struct to_test);
};

#endif
