goncalor/SCDTR/(commit log)

2015-09-30 Added datasheets and support materials.
2015-10-14 First Arduino programs
2015-10-14 Moved a file to the correct location (damn Arduino
2015-10-14 fixed name of file
    [proportional_ctrl.ino]
2015-10-15 Step response
    [StepResponse.csv]
2015-10-16 Added plots and changes made on the lab
    [Graphs and stuff.ods]
2015-10-26 Started an Xcos simulation.
    [data.csv]
2015-10-27 Step Analysis, now averaged values of the sensors, Matlab script
2015-10-27 Improved Arduino and Matlab step ploting
2015-10-28 Steady State working
    [steadystate.csv]
2015-10-29 Tests and Feedfoward
    [PI tests.xlsx]
2015-10-29 Added new data. Feedforward uses a gain.
    [PI tests.xlsx]
2015-10-29 Changed PWM pin (pin 5 higher frequency).
    [PI tests.xlsx]
2015-10-29 D1 and D2 ready.
    [steadystate.csv, steadystate.xlsx]
2015-10-29 New file with timer interrupts.
    Next will make all the controller based on interrupts.
2015-10-30 Added Lux at the LDR in func of PWM at LED.
    [PI tests.xlsx]
2015-10-30 PI working, Diff not working
    [ctrl4_serial.ino]
2015-10-30 Added lux conversions and commands
    [test excels.xlsx]
2015-10-30 Now you can change reference in the middle of the loop
    [test excels.xlsx]
2015-10-30 Demonstração
    [steadystate.xlsx, test excels.xlsx]
2015-11-02 Fixed bug on Integral controler and other small improvements
    [ctrl4_serial.ino]
2015-11-04 PID working, gains set on the defines
    (no filter at derivative yet...)
    [test excels.xlsx]
2015-11-05 Fixed some indentations.
    [test excels.xlsx]
2015-11-05 Copied the ctrl4_serial. Added interrupt routine.
    Does not compile yet (haven't even tried).
2015-11-06 Now works correctly with interrupts. Parenthesis!!
    Previously it didn't work because of missing parenthesis in the define
    of INTERRUPT_TIME.
    [ctrl4_serial.ino]
2015-11-06 Added an interrupt test to the excel.
    [test excels.xlsx]
2015-11-06 Fixed identations and reference updates
    [ctrl4_serial.ino]
2015-11-18 Added a tiny program to write and read the EEPROM.
    The idea is to write a different identifier for each Arduino.
2015-11-26 Added script to check fuses. 0s not written EEPROM
    - 0s are not written to EEPROM anymore. Previously 0s were written by
    accident somehow
    - Checked that the Arduino UNO comes with EESAVE=0, that is "Preserve
    EEPROM memory through the Chip Erase cycle"
2015-12-04 New file where incoming wire data is processed.
    Tested. Midly.
2015-12-06 wire_data_available must be volatile.
2015-12-07 simplex for initial feasible, bug on constructor
    [main.cpp, simplex.cpp, simplex.hpp]
2015-12-07 Fixed simplex. Working with initial feasible solution
    [main.cpp, simplex.cpp]
2015-12-09 Corrected a bug in wireReceiveEvent.
    [wire.ino]
2015-12-09 Both O and E are collected correctly.
    [wire.ino]
2015-12-09 Init simplex implemented. Bugs on generating the new LP.
    [main.cpp, simplex.cpp]
2015-12-10 Prepared data to test simplex with the Arduino LP
2015-12-10 Simplex with problems of approximation
    [main.cpp, simplex.cpp]
2015-12-11 Continued looking for bug on initial simplex
    [main.cpp, simplex.cpp, simplex_test.cpp]
2015-12-12 Added more tests and fixed small bug
    [main.cpp, simplex.cpp, simplex_test.cpp]
2015-12-12 Fixed bug when choosing entering variable simplex
    [main.cpp, simplex.cpp, simplex_test.cpp]
2015-12-12 Fixed flashing during calibration.
    [wire.ino]
2015-12-12 Tested with arduino real values, added function to generate LP from those values
2015-12-13 Improvements in calibration.
2015-12-13 Something is broken here. Saving it for reference.
    [wire.ino]
2015-12-17 Reset implemented, server side, added comments
    [main.cpp, serial.hpp]
2015-12-17 Dynamic masters seems to work fine.
    The master as defined now is who has the power to calibrate and send
    commands to the others.
    There were stability problems when using 61 float circular buffers, so
    the number was reduced.
    [wire.ino]
2015-12-17 Calibration command on server
2015-12-17 Full system reset.Calibration is run only if asked
    [wire.ino]
2015-12-18 Server commands to arduino, buggy
    [serial.hpp, tcp_server.cpp]
2015-12-18 Added case to receive simplex results.
2015-12-18 Removed ack prints.
2015-12-23 PID Controler bibliography
2015-12-24 Root folder is much cleaner. More cleaning needed.
    [Graphs and stuff.ods, PI tests.xlsx, steadystate.xlsx, test excels.xlsx]
2015-12-24 More cleaning. More needed.
    [StepResponse.csv]
2015-12-25 Cleaned up arduino folder.
2015-12-26 Fixed arduino main file name.
2015-12-26 PID: Derivative component
2015-12-26 PID without Phd reference
2015-12-26 PID block diagramm
2015-12-27 Drew the LDR circuit.
2015-12-28 Added figure for steady state.
    [steadystate.csv, steadystate.xlsx]
2015-12-28 Prepared scripts to generate LDR graphs.
    [pwm_to_lux.csv, pwm_to_lux.xlsx]
2015-12-30 Added plot for step response. Edited .ino for that
    [data.csv, steadystate.csv, steadystate.xlsx, step_response.csv]
2015-12-30 Added plot for incremental steps.
    [incstep_response.csv]
2015-12-30 Added step response without capacitor.
    [step_response_no_capacitor.csv]
2016-01-02 Invalid commands only print "inv\n".
2016-01-02 Corrected detail in printing stats' buffers.
    [main_.ino, wire.ino]
2016-01-03 Corrected bug in ftoa().
    [main_.ino, utils.cpp]
2016-01-03 Added plots for stats w/ closed box no occupation.
    [e_closed_o000.csv, f_closed_o000.csv, n_closed_o000.csv]
2016-01-03 Added graphs for open box. Improved automation.
    [e_open_o101.csv, f_open_o101.csv, n_open_o101.csv]
2016-01-03 Wrote about Arduino Communications.
2016-01-03 Added Arduino's GitHub to the references.
2016-01-03 Added one comment to the Arduino code.
